saaralf/Servodekoder/software/sx-monitor-qt-v2/assets/servo_arm.png

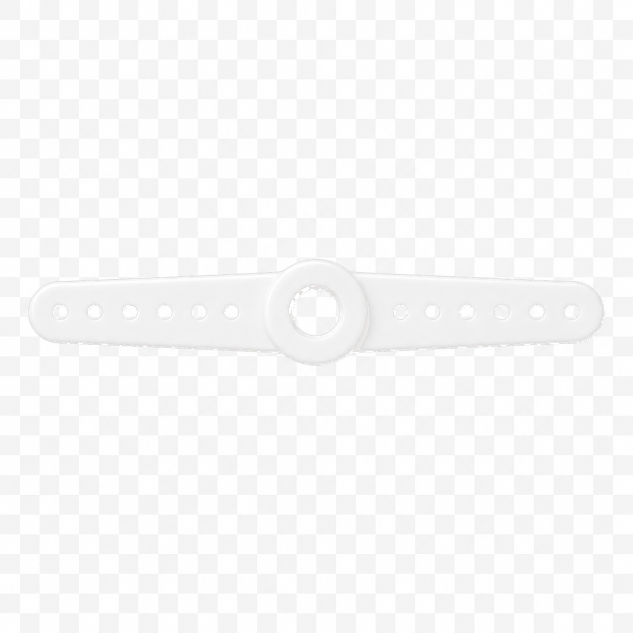
software/sx-monitor-qt-v2/assets/servo_arm.png
