saaralf/Servodekoder/software/sx-monitor-qt-v2/assets/servo_arm_cut.png

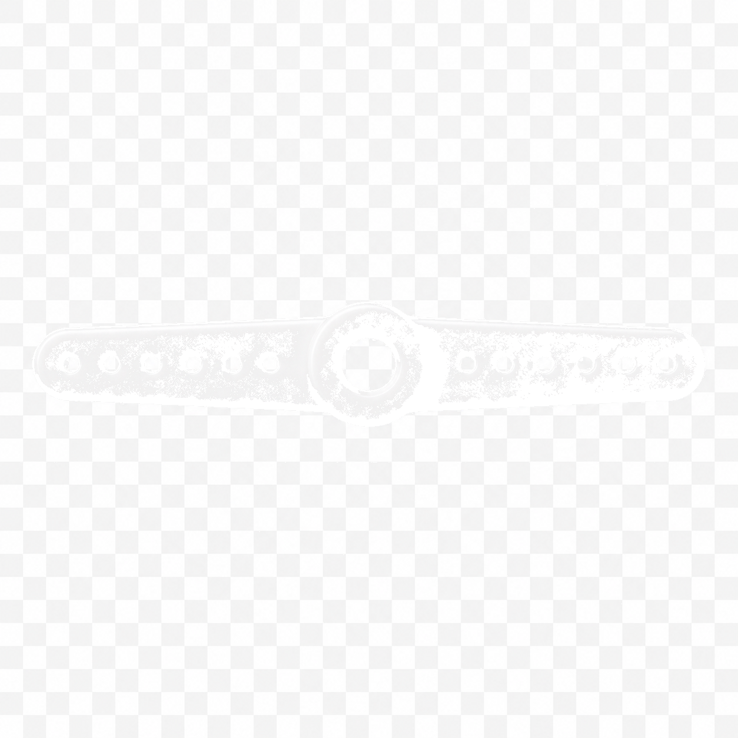
software/sx-monitor-qt-v2/assets/servo_arm_cut.png
