saaralf/Servodekoder/software/sx-monitor-qt-v2/assets/servo_body_raw.png

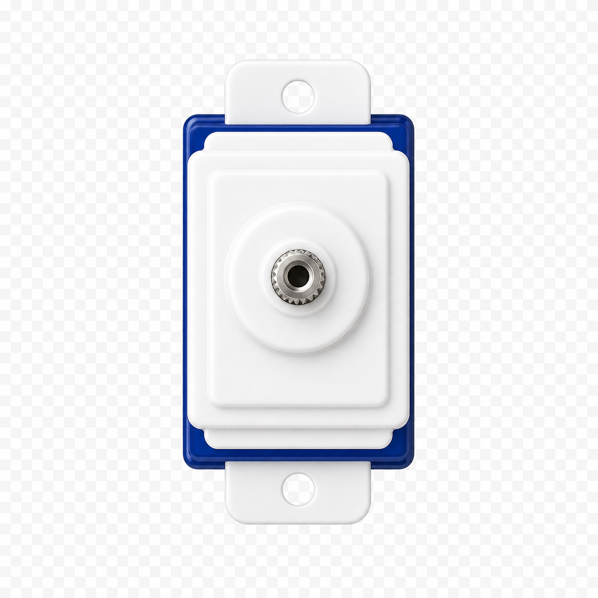
software/sx-monitor-qt-v2/assets/servo_body_raw.png
