saaralf/Servodekoder/hardware/Servo.dxf

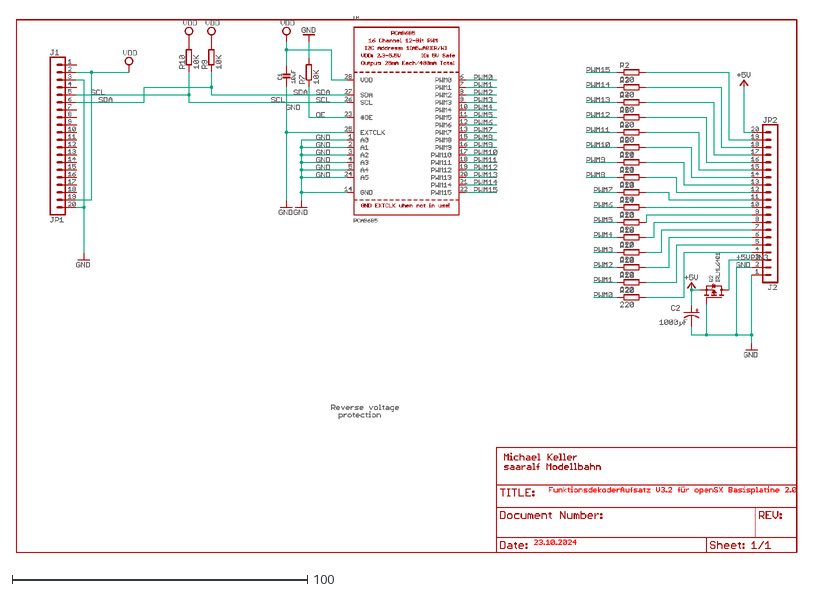
[picture p7: CAD file, 2026-06-01]
hardware/Servo.dxf
264.5 x 181.8
