saaralf/Servodekoder/software/sx-monitor-qt-v2/build-v3/assets/servo_arm_new.png

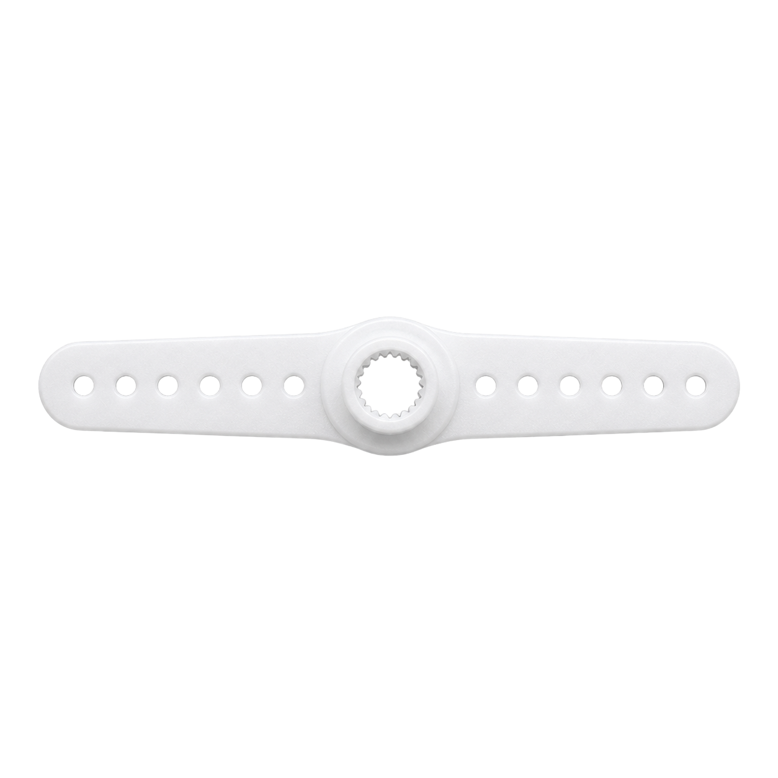
software/sx-monitor-qt-v2/build-v3/assets/servo_arm_new.png
