saaralf/Servodekoder/software/sx-monitor-qt-v2/build-v3/assets/servo_body_blue.png

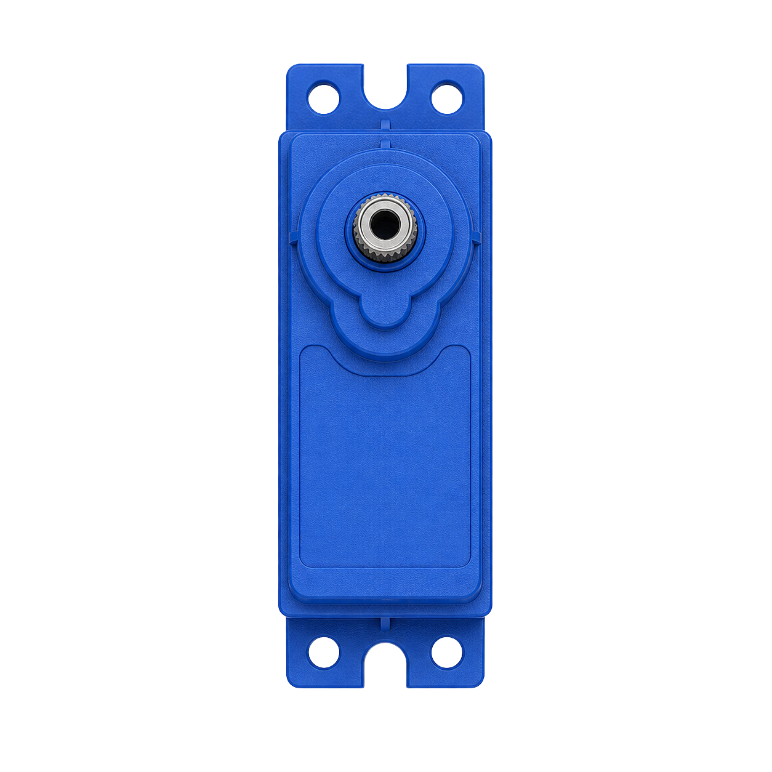
software/sx-monitor-qt-v2/build-v3/assets/servo_body_blue.png
