saaralf/Servodekoder/software/SX-Servo-Aufsatz-TestBackup/README.md

# SX-Servo-Aufsatz Test-Backup

Dieses Verzeichnis enthält eine gesicherte Test-Version von `main.cpp`.

Quelle:
- `software/SX-Servo-Aufsatz/src/main.cpp`

Ziel:
- `software/SX-Servo-Aufsatz-TestBackup/src/main.cpp`
