saaralf/Servodekoder/hardware/Servo.brd

## EAGLE design hardware/Servo.brd (2026-08-30)

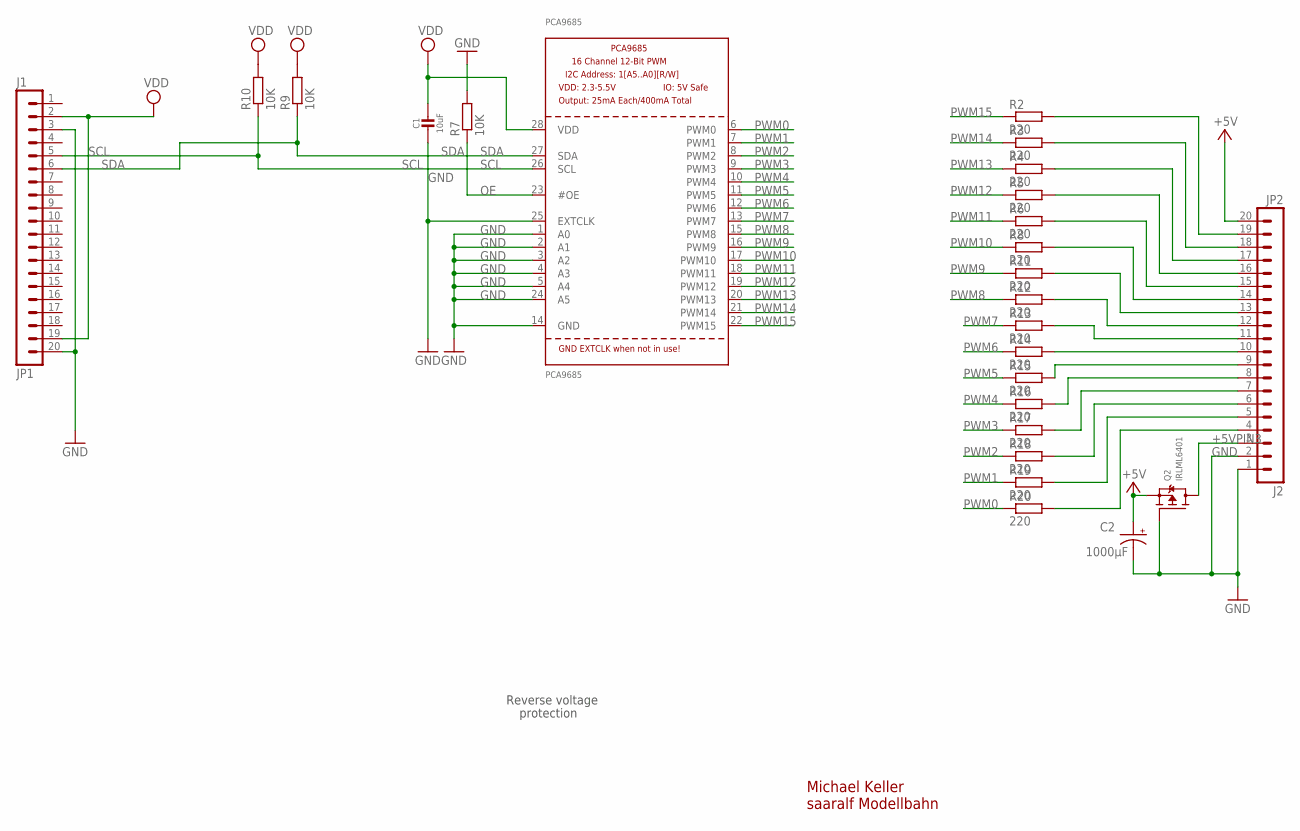
[picture p10: schematic Servo.sch]

Parts:
C1: 10uF; 0805-NO
C2: 1000µF; E3,5-8
JP1: J1; MA20-1
JP2: J2; MA20-1
PCA9685: PCA9685; TSSOP28
Q2: IRLML6401; SOT23-WIDE
R2, R3, R4, R5, R6, R8, R11, R12, R13, R14, R15, R16, R17, R18, R19, R20: 220; M0805
R7, R9, R10: 10K; M0805

Connections:
+5V: C2.+, JP2.20, Q2.2 (S)
+5VPIN3: JP2.3, Q2.3 (D)
GND: C1.2, C2.-, JP1.3, JP1.20, JP2.1, JP2.2, PCA9685.1 (A0), PCA9685.2 (A1), PCA9685.3 (A2), PCA9685.4 (A3), PCA9685.5 (A4), PCA9685.14 (GND), PCA9685.24 (A5), PCA9685.25 (EXTCLK), Q2.1 (G), R7.2
unnamed: JP2.17, R4.2
unnamed: JP2.11, R13.2
unnamed: JP2.10, R14.2
unnamed: JP2.9, R15.2
unnamed: JP2.7, R17.2
unnamed: JP2.6, R18.2
unnamed: JP2.5, R19.2
unnamed: JP2.4, R20.2
unnamed: JP2.15, R6.2
unnamed: JP2.14, R8.2
unnamed: JP2.18, R3.2
unnamed: JP2.13, R11.2
unnamed: JP2.19, R2.2
unnamed: JP2.8, R16.2
unnamed: JP2.16, R5.2
unnamed: JP2.12, R12.2
OE: PCA9685.23 (#OE), R7.1
PWM0: PCA9685.6 (PWM0), R20.1
PWM1: PCA9685.7 (PWM1), R19.1
PWM2: PCA9685.8 (PWM2), R18.1
PWM3: PCA9685.9 (PWM3), R17.1
PWM4: PCA9685.10 (PWM4), R16.1
PWM5: PCA9685.11 (PWM5), R15.1
PWM6: PCA9685.12 (PWM6), R14.1
PWM7: PCA9685.13 (PWM7), R13.1
PWM8: PCA9685.15 (PWM8), R12.1
PWM9: PCA9685.16 (PWM9), R11.1
PWM10: PCA9685.17 (PWM10), R8.1
PWM11: PCA9685.18 (PWM11), R6.1
PWM12: PCA9685.19 (PWM12), R5.1
PWM13: PCA9685.20 (PWM13), R4.1
PWM14: PCA9685.21 (PWM14), R3.1
PWM15: PCA9685.22 (PWM15), R2.1
SCL: JP1.5, PCA9685.26 (SCL), R10.1
SDA: JP1.6, PCA9685.27 (SDA), R9.1
VDD: C1.1, JP1.2, JP1.19, PCA9685.28 (VDD), R9.2, R10.2

Notes on the sheet:
Michael Keller saaralf Modellbahn
Reverse voltage
protection

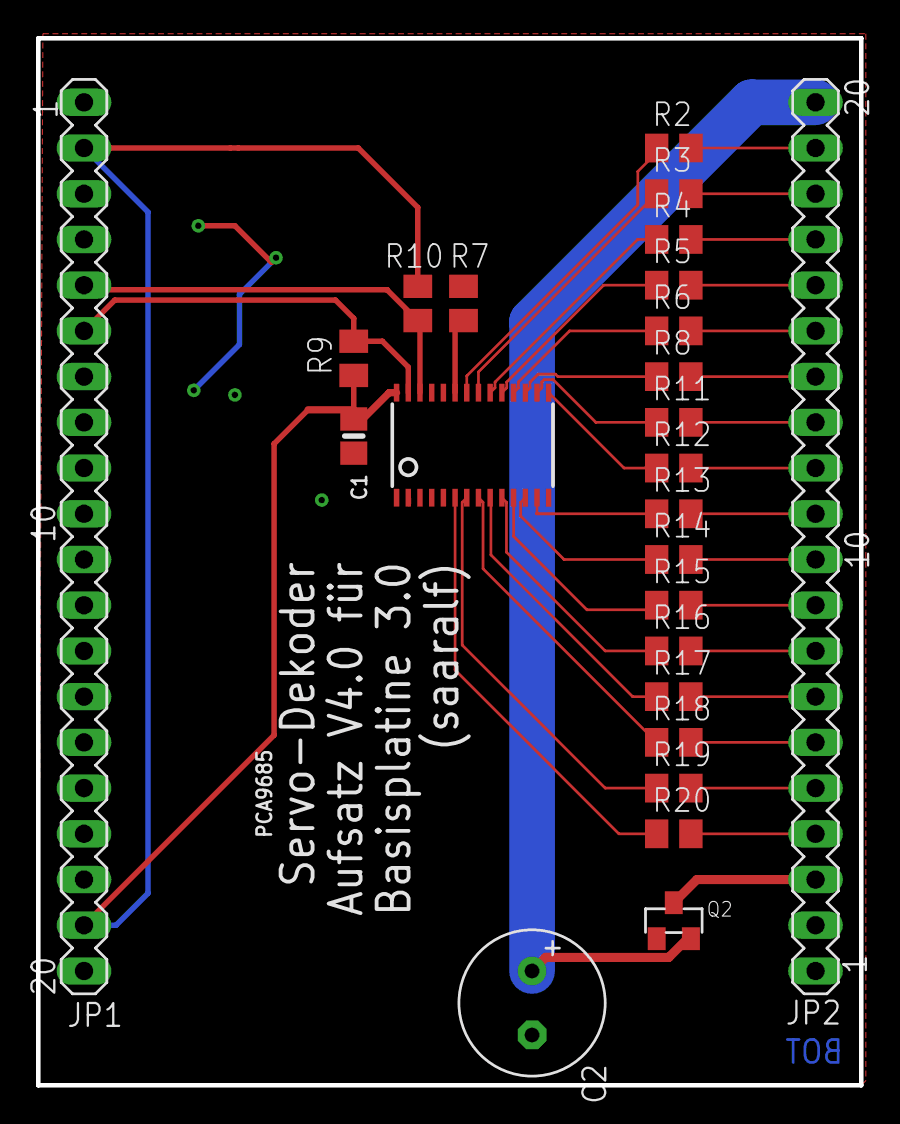
[picture p11: board Servo.brd from above]

Board: 2 copper layers, 45.7 x 58.2 mm, 25 parts (0 on the bottom side), 39 nets.
