saaralf/Servodekoder/hardware/SXV0300_Servo.brd

## EAGLE design hardware/SXV0300_Servo.brd (2026-04-14)

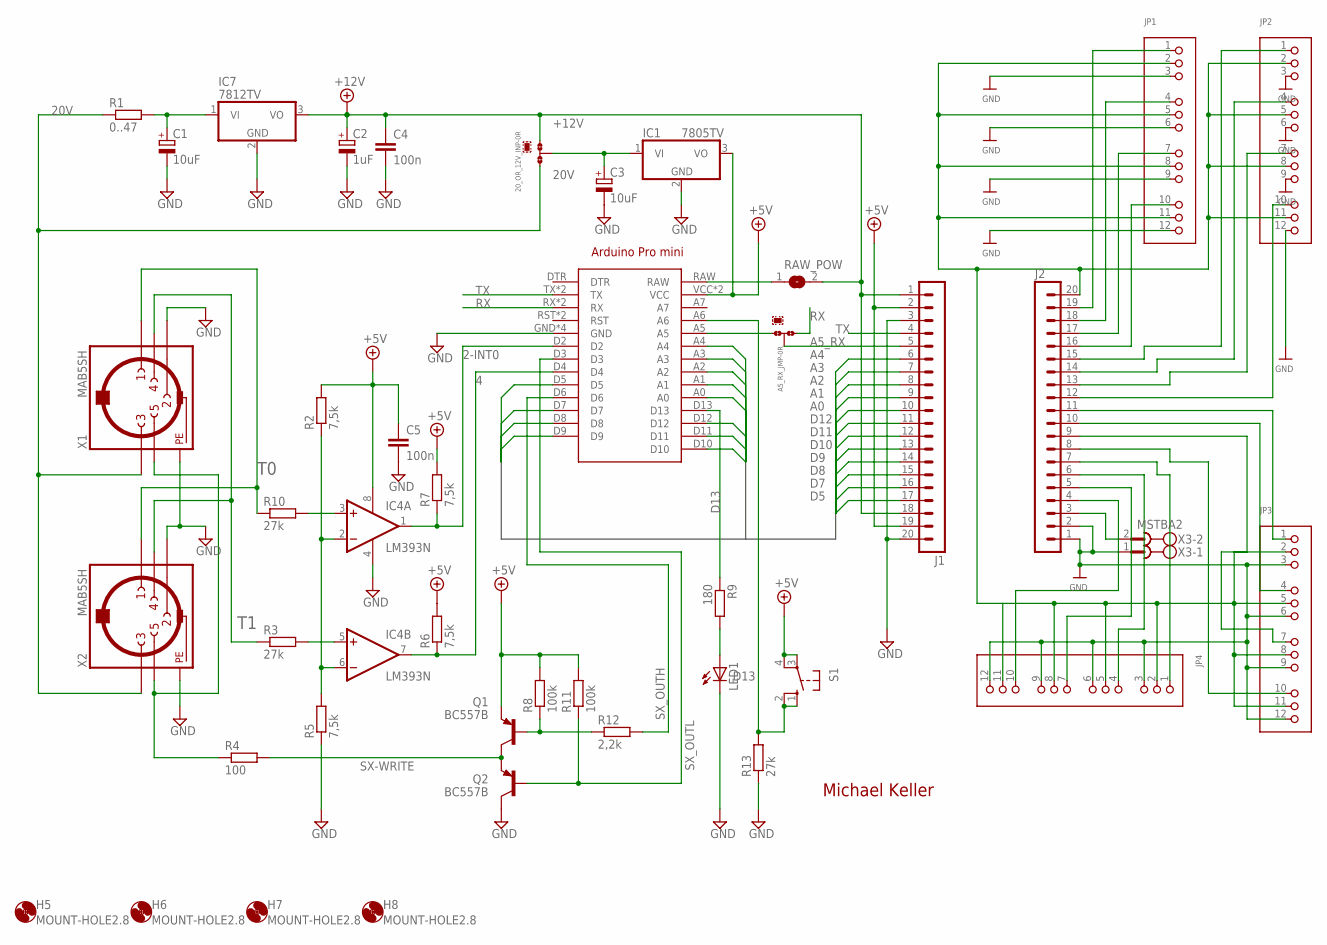
[picture p12: schematic SXV0300_Servo.sch]

Parts:
20_OR_12V_INP: 0R-JUMPA; A0R-JMP
A5_RX_JMP: 0R-JUMPB; B0R-JMP
ARDUINO1: ARDUINO_PRO_MINI
C1: 10uF; E2,5-7
C2: 1uF; E2,5-7
C3: 10uF; SMC_C
C4, C5: 100n; C050-025X075
H5, H6, H7, H8: MOUNT-HOLE2.8; 2,8
IC1: 7805TV; TO220V
IC4: LM393N; DIL08
IC7: 7812TV; TO220V
J1, J2: MA20-1
JP1, JP2, JP3, JP4: HEADER-3X04; 3X04
LED1: LED3MM
Q1, Q2: BC557B; TO92-EBC
R1: 0..47; 0207/12
R2, R5, R6, R7: 7,5k; 0207/10
R3, R10, R13: 27k; 0207/10
R4: 100; 0207/10
R8, R11: 100k; 0207/10
R9: 180; 0207/2V
R12: 2,2k; 0207/10
RAW_POW: SJ
S1: 10-XX; B3F-10XX
X1, X2: MAB5SH
X3: MSTBA2

Connections:
2-INT0: ARDUINO1.D2, IC4.1 (OUT), R7.1
4: ARDUINO1.D4, IC4.7 (OUT), R6.1
20V: 20_OR_12V_INP.3, R1.1, X1.3, X2.3
+5V: ARDUINO1.VCC, ARDUINO1.VCC@1 (VCC), C5.1, IC1.3 (VO), IC4.8 (V+), J1.2, J1.19, Q1.E, R2.2, R6.2, R7.2, R8.2, R11.2, S1.3, S1.4 (P1)
+12V: 20_OR_12V_INP.1, C2.+, C4.1, IC7.3 (VO), J1.1, J1.18, RAW_POW.2
A0: ARDUINO1.A0, J1.10
A1: ARDUINO1.A1, J1.9
A2: ARDUINO1.A2, J1.8
A3: ARDUINO1.A3, J1.7
A4: ARDUINO1.A4, J1.6
A5: A5_RX_JMP.3, ARDUINO1.A5
A5_RX: A5_RX_JMP.2, J1.5
D5: ARDUINO1.D5, J1.17
D7: ARDUINO1.D7, J1.16
D8: ARDUINO1.D8, J1.15
D9: ARDUINO1.D9, J1.14
D10: ARDUINO1.D10, J1.13
D11: ARDUINO1.D11, J1.12
D12: ARDUINO1.D12, J1.11
D13: ARDUINO1.D13, R9.1
GND: ARDUINO1.GND, ARDUINO1.GND@1 (GND), ARDUINO1.GND@2 (GND), ARDUINO1.GND@3 (GND), C1.-, C2.-, C3.-, C4.2, C5.2, IC1.2 (GND), IC4.4 (V-), IC7.2 (GND), J1.3, J1.20, J2.1, J2.2, JP1.3, JP1.6, JP1.9, JP1.12, JP2.3, JP2.6, JP2.9, JP2.12, JP3.3, JP3.6, JP3.9, JP3.12, JP4.3, JP4.6, JP4.9, JP4.12, LED1.K (C), Q2.C, R5.1, R13.1, X1.2, X1.PE, X1.PE@ (PE), X1.PE@1 (PE), X1.PE@2 (PE), X2.2, X2.PE, X2.PE@ (PE), X2.PE@1 (PE), X2.PE@2 (PE), X3.1
unnamed: LED1.A, R9.2
unnamed: C1.+, IC7.1 (VI), R1.2
unnamed: R4.1, X1.5, X2.5
unnamed: IC4.3 (+IN), R10.2
unnamed: IC4.5 (+IN), R3.2
unnamed: J2.20, JP1.2, JP1.5, JP1.8, JP1.11, JP2.2, JP2.5, JP2.8, JP2.11, JP3.2, JP3.5, JP3.8, JP3.11, JP4.2, JP4.5, JP4.8, JP4.11
unnamed: IC4.2 (-IN), IC4.6 (-IN), R2.1, R5.2
unnamed: J2.3, X3.2
unnamed: J2.4, JP4.10
unnamed: J2.5, JP4.7
unnamed: J2.6, JP4.4
unnamed: J2.7, JP4.1
unnamed: J2.8, JP3.10
unnamed: J2.9, JP3.7
unnamed: J2.10, JP3.4
unnamed: J2.11, JP3.1
unnamed: J2.12, JP2.10
unnamed: J2.13, JP2.7
unnamed: J2.14, JP2.4
unnamed: J2.15, JP2.1
unnamed: J2.16, JP1.10
unnamed: J2.17, JP1.7
unnamed: J2.18, JP1.4
unnamed: J2.19, JP1.1
unnamed: ARDUINO1.A6, R13.2, S1.1 (S), S1.2 (S1)
unnamed: Q1.B, R8.1, R12.1
unnamed: ARDUINO1.RAW, RAW_POW.1
unnamed: 20_OR_12V_INP.2, C3.+, IC1.1 (VI)
RX: A5_RX_JMP.1, ARDUINO1.RX, ARDUINO1.RX@1 (RX)
SX-WRITE: Q1.C, Q2.E, R4.2
SX_OUTH: ARDUINO1.D6, R12.2
SX_OUTL: ARDUINO1.D3, Q2.B, R11.1
T0: R10.1, X1.1, X2.1
T1: R3.1, X1.4, X2.4
TX: ARDUINO1.TX, ARDUINO1.TX@1 (TX), J1.4

Notes on the sheet:
Michael Keller

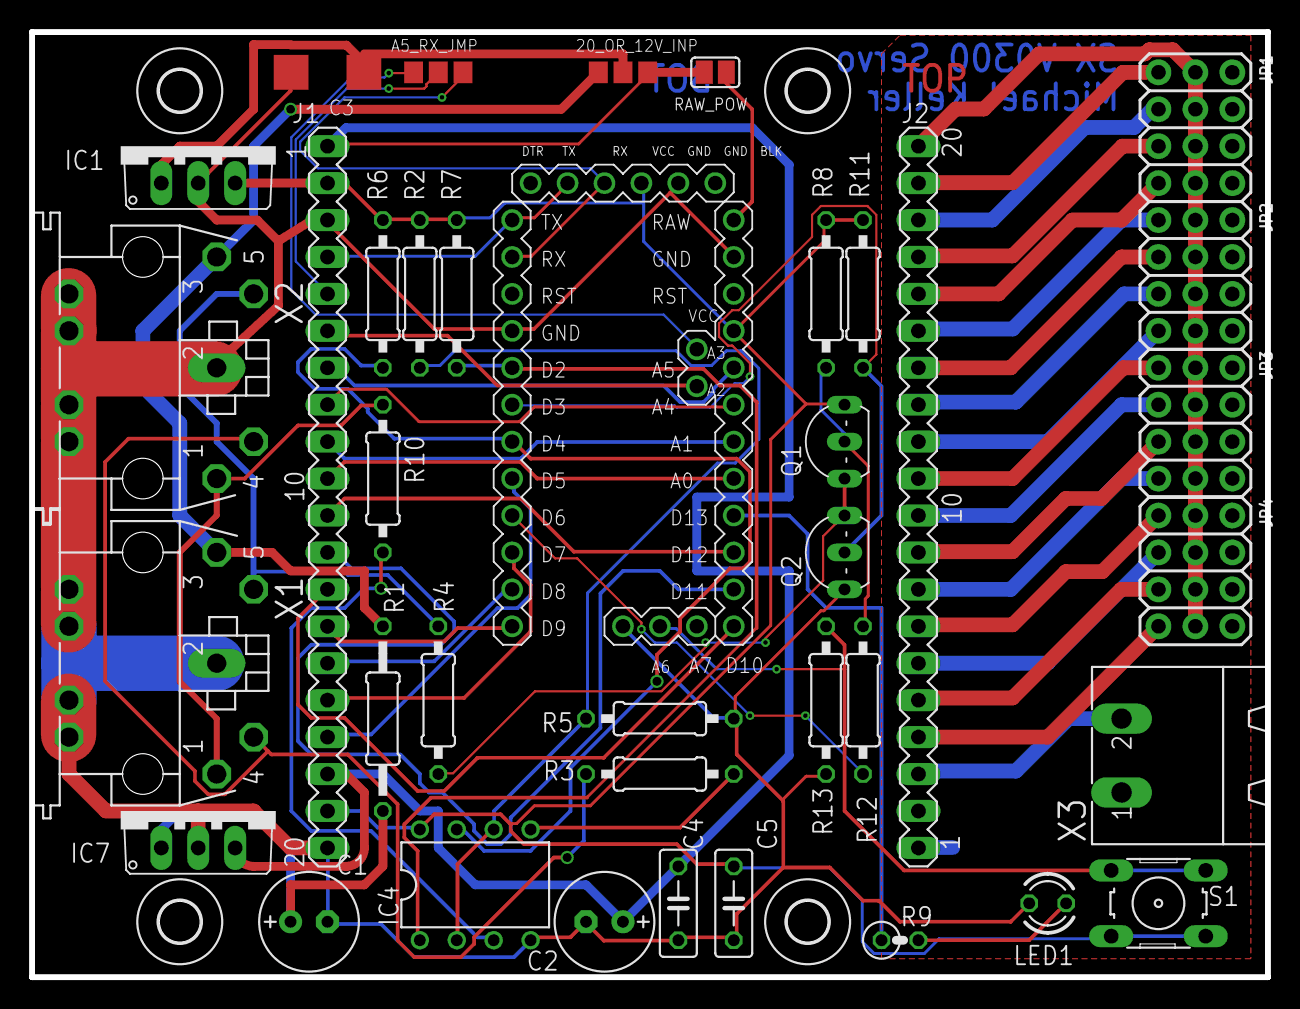
[picture p13: board SXV0300_Servo.brd from above]

Board: 2 copper layers, 85.0 x 65.0 mm, 42 parts (0 on the bottom side), 56 nets.
