saaralf/Servodekoder/software/sx-monitor-qt-v2/app-v3/src/mainwindow_v3.h

#pragma once
#include <QMainWindow>
#include <QString>
#include "dual_runtime_controller.h"
class ConnectionPanel; class QTextEdit;

class MainWindowV3 : public QMainWindow {
    Q_OBJECT
public:
    explicit MainWindowV3(QWidget* parent=nullptr);
private:
    void setupDaemonMenu();
    void applyRmxCentralStyle();
    bool systemctlUser(const QStringList& args, QString* output=nullptr);
    bool serviceActive(const QString& service);
    void daemonServiceAction(const QString& service, const QString& action, const QString& label);
    void startRequiredDaemonsIfNeeded();
    void connectBackendFromPanel(BackendKind backend);
    void disconnectBackend(BackendKind backend);
    void showUsbPortConfigDialog();
    void appendLog(const QString& msg);
    QStringList scanUsbSerialPorts(QString* details=nullptr) const;
    bool writeDaemonOverride(BackendKind backend, const QString& serialPath, QString* output=nullptr);

    ConnectionPanel* sxPanel{};
    ConnectionPanel* rmxPanel{};
    QTextEdit* log{};
    QString logFilePath;
    DualRuntimeController ctrl;
};
