saaralf/Servodekoder/(commit log)

2026-04-14 Initial commit: Servo decoder hardware + test sketch
    [SXV0300_Servo.brd, SXV0300_Servo.sch, Servo.brd, Servo.sch]
2026-04-14 Add wiring docs, short description with images, and gitignore
2026-04-14 Add new board photos and embed them in README and short description
2026-04-14 Import PlatformIO project SX-Servo-Aufsatz into software folder
2026-04-14 Drive PCA9685 servo channel 0 in test loop with serial status
2026-04-15 Extend ServoTest with dedicated channel-0 test command
2026-04-16 ServoTest: start at 0° and add +/- serial control for servo 0
2026-04-16 ServoTest: support variable +/- steps via serial (e.g. + 30, - 30)
2026-04-16 ServoTest: add signed mode for channel 0 (-90..0..+90 around center)
2026-04-16 SX-Servo-Aufsatz main.cpp: signed servo-0 control (-90..0..+90)
2026-04-16 SX-Servo-Aufsatz: add relative servo-0 mode around configurable zero point
2026-04-16 Add EEPROM-backed servo soft-limit calibration workflow (no switch feedback)
2026-04-16 Allow finer +/- calibration and default travel up to +/-40 with clear softlimit hint
2026-04-16 Include servo status output in 's' I2C scan command
2026-04-16 On boot: detect EEPROM config, report source, and always move servo to center first
2026-04-16 Generalize turnout logic to all 16 servos with per-servo EEPROM config and active-servo selection
2026-04-17 Add backup copy of current SX-Servo-Aufsatz main.cpp test program
2026-04-17 Add SX30-based 16-servo turnout decoder sketch with programming mode and EEPROM config
2026-04-17 Add PlatformIO config for SX30-ServoDecoder project
2026-04-17 Restructure SX30-ServoDecoder to PlatformIO standard src/main.cpp layout
2026-04-17 Add detailed German documentation for SX30-ServoDecoder main.cpp
2026-04-17 Support single SX address mode (8 servos) with disabled-address handling
2026-05-02 Wiederstände als 0803
    [Servo.brd, Servo.sch]
2026-05-03 Test und ServoAufsatzSX Verion1
2026-05-03 SX-Servo-Aufsatz: SX30 programmer mode, EEPROM config, servo test channels and relax
2026-05-04 SXServo: stabilize wizard setup flow and document verified procedure
    [main.cpp]
2026-05-04 SXServo: add TODO for QT prog-button feedback, D13 setup-mode indicator
2026-05-04 sx-monitor-qt-v2: add Servo-Bildansicht tab with 16 tiles (2x8)
2026-05-05 sx-monitor-qt-v2: replace ASCII arm with painted servo arm widget
    [sx_monitor_qt_v2.cpp]
2026-05-05 sx-monitor-qt-v2: render long double-sided servo horn for realistic arm view
2026-05-05 sx-monitor-qt-v2: style servo tile closer to KY66 (blue body, white long horn)
2026-05-05 sx-monitor-qt-v2: render servo upright (vertical body orientation)
2026-05-05 sx-monitor-qt-v2: use generated body/arm image assets with rotatable arm overlay
2026-05-05 sx-monitor-qt-v2: match widget bg to app theme and restore visible arm overlay
2026-05-05 sx-monitor-qt-v2: always draw visible upright servo body behind rotating arm
2026-05-05 sx-monitor-qt-v2: force high-contrast visible horn rendering in servo tiles
2026-05-05 sx-monitor-qt-v2: render directly from user-provided body/arm assets
2026-05-05 sx-monitor-qt-v2: restore original servo body asset (full source image)
2026-05-05 sx-monitor-qt-v2: fix missing body visibility and clean arm alpha overlay
    [sx_monitor_qt_v2.cpp]
2026-05-05 sx-monitor-qt-v2: step 1 show upright servo body only
2026-05-05 sx-monitor-qt-v2: remove white body background and use cut body asset
2026-05-05 sx-monitor-qt-v2: integrate new blue servo body image asset
2026-05-05 sx-monitor-qt-v2: integrate new servo arm image asset
2026-05-05 sx-monitor-qt-v2: align arm rotation to hub via automatic alpha-center offset
2026-05-05 sx-monitor-qt-v2: use user-edited transparent servo body image
2026-05-05 sx-monitor-qt-v2: use user-edited transparent servo arm image
2026-05-05 sx-monitor-qt-v2: set arm neutral orientation to vertical
2026-05-05 sx-monitor-qt-v2: adjust arm overlay trim to align with servo hub
2026-05-05 sx-monitor-qt-v2: move arm higher/right and allow arm to extend beyond tile
2026-05-05 sx-monitor-qt-v2: fine-tune arm hub alignment from screenshot feedback
2026-05-05 sx-monitor-qt-v2: final x-offset tweak for arm-to-hub centering
2026-05-05 sx-monitor-qt-v2: apply final 1px right arm alignment tweak
2026-05-05 sx-monitor-qt-v2: apply large visible arm x-offset for fast alignment
2026-05-05 sx-monitor-qt-v2: align arm by matching asset hub centers (body hub vs arm hub)
2026-05-05 sx-monitor-qt-v2: enlarge servo image area so full arm stays visible
2026-05-05 sx-monitor-qt-v2: fit combined body+offset arm scene into tile to prevent clipping
    [sx_monitor_qt_v2.cpp]
2026-05-05 sx-monitor-qt-v2: restructure visual grid with per-column Servo/Adresse/Bit rows
2026-05-05 sx-monitor-qt-v2: place address 2 controls between first and second servo rows
2026-05-05 sx-monitor-qt-v2: stop retriggering K10 on every move/store click to prevent re-centering jitter
    [sx_monitor_qt_v2.cpp]
2026-05-05 sx-monitor-qt-v2: add baud dropdown and fail connect when FE test write fails
    [sx_monitor_qt_v2.cpp]
2026-05-05 sx-monitor-qt-v2: start visual setup (K10) once per context so V2 move buttons work
2026-05-05 sx-monitor-qt-v2: use 1-based servo index for K11 in visual move/store commands
2026-05-05 sx-monitor-qt-v2: add visual-tab setup end/abort buttons (K10=3/2) to control D13 state
2026-05-05 sx-monitor-qt-v2: make visual move clicks deterministic (fixed step=1, longer K13 pulse)
    [sx_monitor_qt_v2.cpp]
2026-05-05 SX30-ServoDecoder: allow serial setup commands even during SX-wizard setup mode
2026-05-06 sx-monitor-qt-v2: use 1-based servo id on K11 in shared wizard handlers
2026-05-06 sx-monitor-qt-v2: revert shared K11 servo index to 0-based to match firmware/programmer behavior
    [sx_monitor_qt_v2.cpp]
2026-05-06 sx-monitor-qt-v2: revert AddrB auto-fallback; keep explicit AddrB and debug output
    [sx_monitor_qt_v2.cpp]
2026-05-09 Qt V2: stabilize wizard timing/priming for K10..K15 pulses
    [sx_monitor_qt_v2.cpp]
2026-05-09 Qt V2: auto-verify move via CFG request and resolve pending move on CFG_END
    [sx_monitor_qt_v2.cpp]
2026-05-09 Firmware SX wizard: swap move direction mapping for SX path and bump FW to 2026-05-09c
    [main.cpp]
2026-05-09 Wizard servo-lock: ignore foreign select ACKs in Qt, lock move/store to one servo, require sxServo match on store; bump FW to 2026-05-09i
2026-05-09 Firmware: lock wizard to initial SX servo within session to prevent cross-servo twitch; clear lock on end; bump FW to 2026-05-09j
    [main.cpp]
2026-05-09 Qt telemetry stabilization: throttle auto-CFG on move, block overlapping CFG requests, and require complete CFG import for ACK via CFG
2026-05-09 Qt V2 UX hardening: disable servo tile inputs while ACK is pending; re-enable on ACK ok/timeout
2026-05-09 Firmware diagnostics: log ACK_SETUP_STORE_REJECT with guard/edge/session/servo context; bump FW to 2026-05-09k
2026-05-09 Qt telemetry parser: classify unknown lines as noise and ignore them for wizard state handling
    [sx_monitor_qt_v2.cpp]
2026-05-09 SX wizard noise hardening: restrict session-id to 1..63 and disable raw bitmask normalization for cmd/move/store; bump FW to 2026-05-09m
    [main.cpp, sx_monitor_qt_v2.cpp]
2026-05-09 Fix Serial-Wizard gating: bypass SX session-id blocks for move/store and mark serial start as active session
    [sx_monitor_qt_v2.cpp]
2026-05-12 GUI sync fix: keep live servo arm pose from ACK_SETUP_*; use CFG midpoint only before first live pose
    [sx_monitor_qt_v2.cpp]
2026-05-12 Serial-Wizard stabilization: disable auto-CFG after moves and add short inter-command quiet time
    [sx_monitor_qt_v2.cpp]
2026-05-12 UI lock hardening: disable servo tiles outside active setup and gray out SX send controls during active Serial-Wizard
2026-05-12 Firmware: enforce PROG LED off when track power is ON; close setup/wizard state on track ON; bump FW to 2026-05-09n
2026-05-12 Serial-Wizard UX fixes: prevent repeated START spam, reset setup state on save/abort, and auto-enable/disable setup/SX-send controls
    [sx_monitor_qt_v2.cpp]
2026-05-12 SX connect UX: show explicit warning dialogs on connect/open failure and display tty device with by-id hint while using by-id internally
    [sx_monitor_qt_v2.cpp]
2026-05-12 Connect diagnostics: always log failed SX connect attempts and show tty+by-id in error messages
    [sx_monitor_qt_v2.cpp]
2026-05-12 SX connect dialog: show both entered port text and internally resolved port in open-failure message
    [sx_monitor_qt_v2.cpp]
2026-05-20 feat(daemon): add dual backend sx/rmx daemon with unified socket API
2026-05-21 feat(qt): add SX/RMX backend selector and immediate track refresh on connect
2026-05-22 feat(qt-v3): log RX frames per backend in main log
2026-05-22 feat(qt-v3): add Read Test button with READADR request path
2026-05-22 feat(qt-v3): add auto-read button for ADR126/127 on SX and RMX
2026-05-22 feat(qt-v3): add RX filter toggle for ADR126/127
2026-05-22 feat(qt-v3): add clear-log button to test row
2026-05-22 feat(qt-v3): add grouped test/preset button batch for SX/RMX
2026-05-22 feat(qt-v3): switch SX/RMX monitor tabs to 0..111 3-column addr/dec/bits layout
2026-05-22 refactor(qt-v3): switch monitor tables to V2 28x12 four-block layout
2026-05-22 feat(qt-v3): port Servo-Programmer tab UI from V2 with core K10..K14 actions
2026-05-22 feat(qt-v3): add Servo-Bildansicht V2 tab scaffold with 16 servo tiles
2026-05-22 feat(qt-v3): enhance V2 visual servo tab with per-tile actions and dynamic addr/bit mapping
2026-05-22 feat(qt-v3): add live servo angle indicators in V2 visual tab from RX bits
2026-05-22 feat(qt-v3): port V2 ServoArmWidget assets into visual tab tiles
2026-05-22 refactor(qt-v3): align visual servo tab structure closer to original V2 layout
2026-05-24 docs(qt-v3): add QA guide for Servo-Bildansicht V2 tab
2026-05-24 fix(qt-v3): address QA findings in visual servo tab and daemon connection UI
    [connection_panel.cpp, mainwindow_v3.cpp]
2026-05-24 fix(qt-v3): show daemon protocol lines and clamp visual servo step increments
    [mainwindow_v3.cpp]
2026-05-24 fix(qt-v3): default window fits servo visual tab while allowing scroll on resize
    [mainwindow_v3.cpp]
2026-05-24 feat(sxbusd2): keep daemon online and auto-probe for SX hardware
2026-05-24 feat(qt-v3): add RMX style track start control
2026-05-24 fix(qt-v3): stabilize connection row label widths
    [connection_panel.cpp]
2026-05-24 ui(qt-v3): enlarge SX bit cells and button-style bit text
2026-05-24 ui(qt-v3): use real bit buttons in SX monitor
2026-05-24 feat(qt-v3): add SX monitor bit order switch for bit buttons
2026-05-24 feat(qt-v3): parity bit-button controls for RMX monitor
2026-05-24 fix(qt-v3): skip daemon start/connect when USB port is unconfigured
    [mainwindow_v3.cpp]
2026-05-25 fix: make v3 servo assets resilient with post-build copy
    [mainwindow_v3.cpp]
2026-06-01 Neue Version V2 des ServoAufsatzes
    [Servo.brd, Servo.dxf, Servo.sch, ServoV2.brd, ServoV2.sch]
2026-08-30 Hardware V4.0
    [Servo.brd, Servo.sch]
2026-10-30 SX30-ServoDecoder: fix servo auto-release in setup; add h/i/z/e/k commands; detailed validation errors; hold 2s default
